alextac98/RBE-1001/(list of files, cad)

Other CAD files:
Field Parts/Barn and Rad.ipt
Field Parts/Egg.ipt
Field Parts/Field.ipt
Field Parts/Field_Assy.iam
Field Parts/OldVersions/Barn and Rad.0002.ipt
Field Parts/OldVersions/Field.0003.ipt
Field Parts/OldVersions/Field_Assy.0001.iam
Field Parts/OldVersions/Field_Assy.0002.iam
Field Parts/OldVersions/Perch.0001.ipt
Field Parts/OldVersions/Ramp.0001.ipt
Field Parts/Pen.ipt
Field Parts/Perch.ipt
Field Parts/Ramp.ipt
