alextac98/RBE-1001/(commit log)

2017-04-28 finished but not tested DT.h file and Motor.h + Motor.cpp
2017-04-28 bug fixes, not tested
    [Drivetrain.cpp, Drivetrain.h]
2017-08-08 Add project files from Google Drive
    [Barn and Rad.0002.ipt, Barn and Rad.ipt, Drive Calcs.xls, Egg.ipt, Field.0003.ipt, Field.ipt, Field_Assy.0001.iam, Field_Assy.0002.iam]
